TLNKhanh/TinyKey/docs/images/board-bottom.png

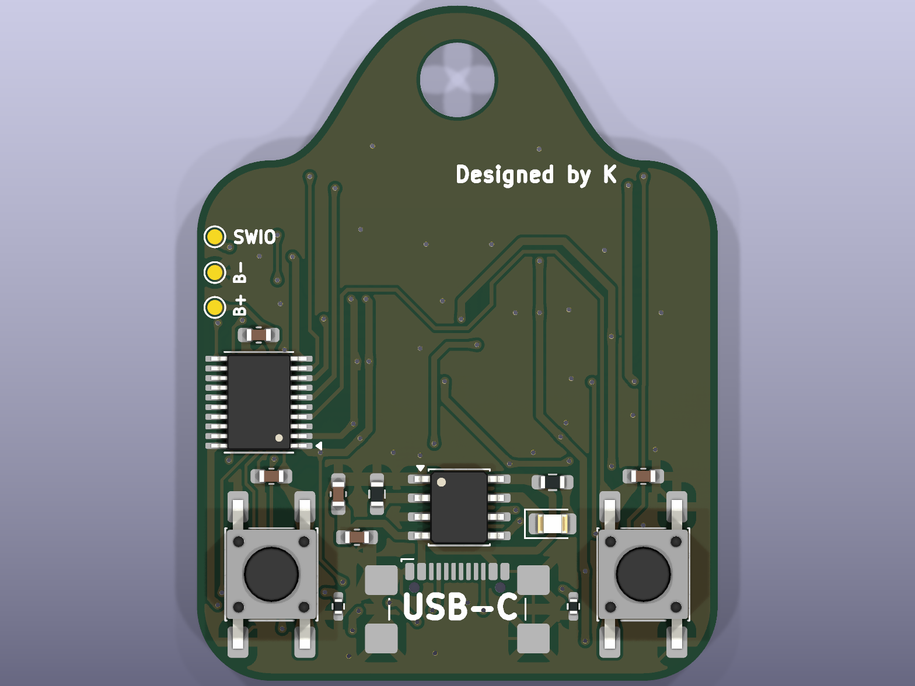
docs/images/board-bottom.png
