TLNKhanh/TinyKey/docs/images/board-hero.jpg

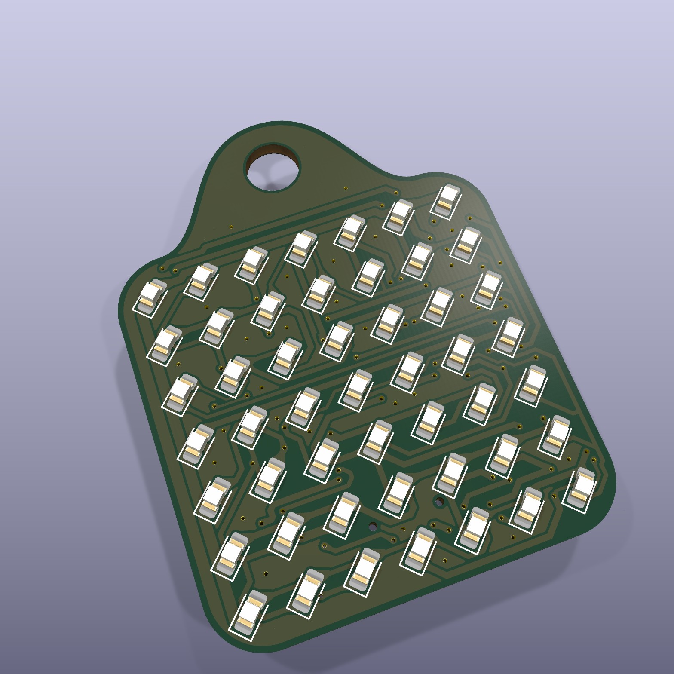
docs/images/board-hero.jpg
