TLNKhanh/TinyKey/docs/images/board-top.png

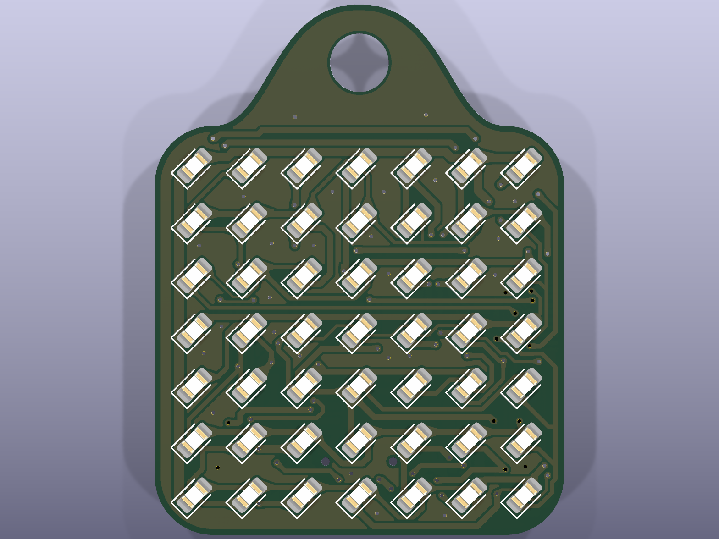
docs/images/board-top.png
