TLNKhanh/TinyKey/docs/images/schematic.png

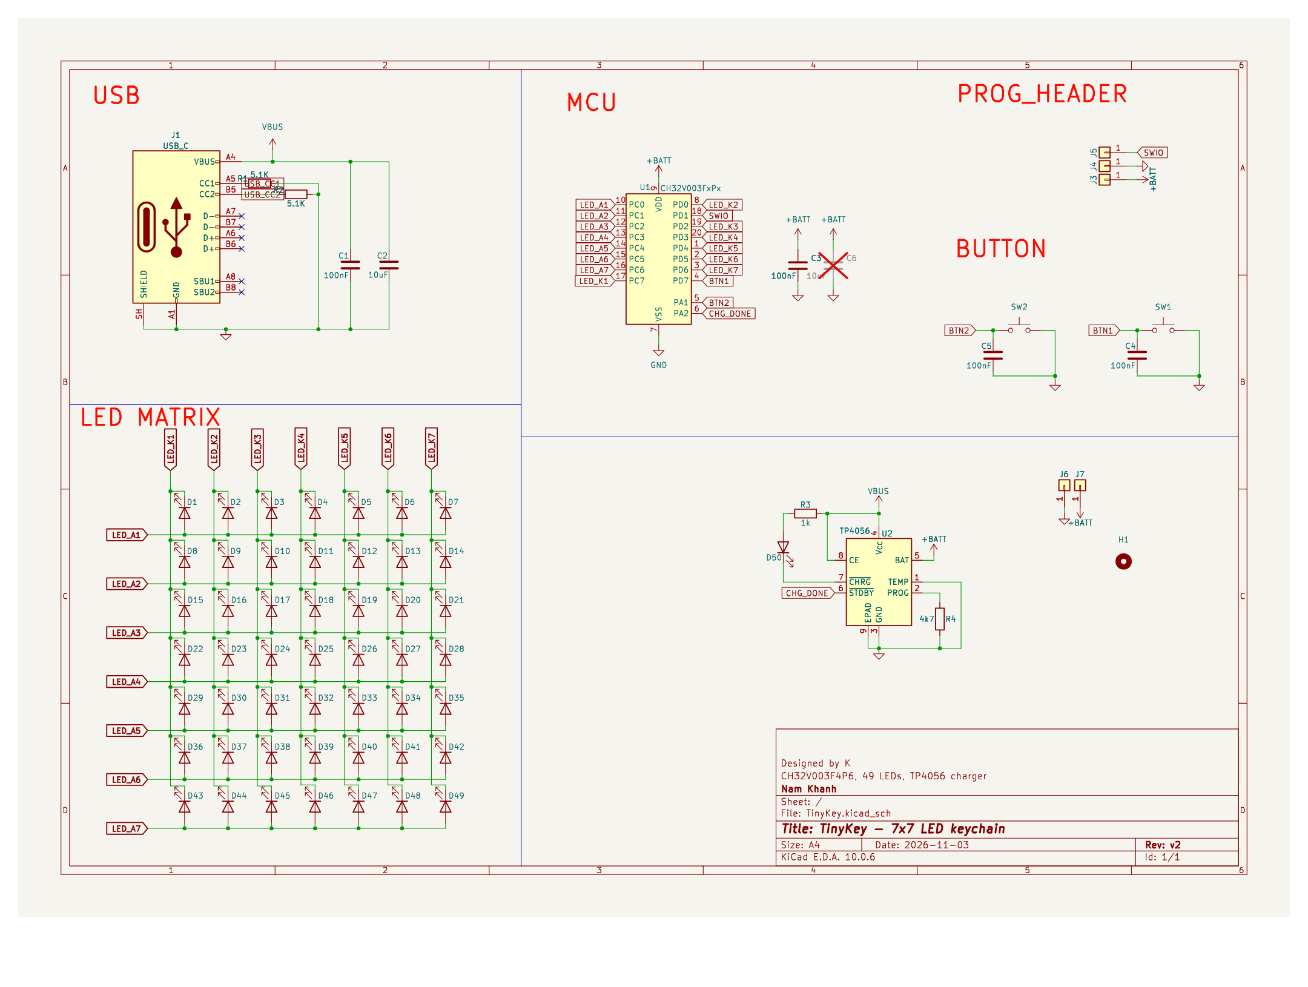
docs/images/schematic.png
