TLNKhanh/TinyKey/hardware/bom.csv

Refs | Value | Footprint | Qty | DNP
C1,C3-C5 | 100nF | Capacitor_SMD:C_0603_1608Metric_Pad1.08x0.95mm_HandSolder | 4
C2 | 10uF | Capacitor_SMD:C_0603_1608Metric_Pad1.08x0.95mm_HandSolder | 1
D1-D50 | LED | LED_SMD:LED_0805_2012Metric_Pad1.15x1.40mm_HandSolder | 50
J1 | USB_C | Connector_USB:USB_C_Receptacle_GCT_USB4110 | 1
J3,J5-J7 | Conn_01x01 | TestPoint:TestPoint_Pad_D1.0mm | 4
R1,R2 | 5.1K | Resistor_SMD:R_0402_1005Metric_Pad0.72x0.64mm_HandSolder | 2
R3 | 1k | Resistor_SMD:R_0603_1608Metric_Pad0.98x0.95mm_HandSolder | 1
R4 | 4k7 | Resistor_SMD:R_0603_1608Metric_Pad0.98x0.95mm_HandSolder | 1
SW1,SW2 | SW_Push | Button_Switch_SMD:SW_Push_1P1T_NO_E-Switch_TL3301NxxxxxG | 2
U1 | CH32V003FxPx | Package_SO:TSSOP-20_4.4x6.5mm_P0.65mm | 1
U2 | TP4056 | Package_SO:SOIC-8-1EP_3.9x4.9mm_P1.27mm_EP2.41x3.81mm | 1
