TLNKhanh/TinyKey/docs/hardware/TinyKey-pcb-top.pdf

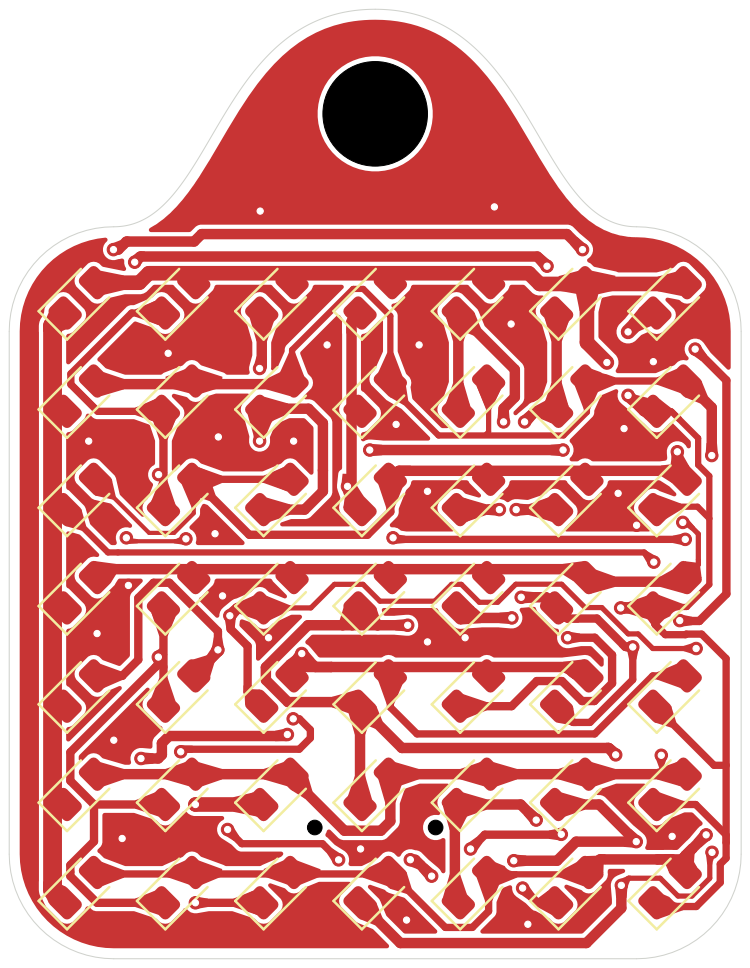
[picture p8: page 1]

Size: A4 | Rev:
KiCad E.D.A. 10.0.6 | Id: 1/1
