TLNKhanh/TinyKey/docs/hardware/TinyKey-schematic.pdf

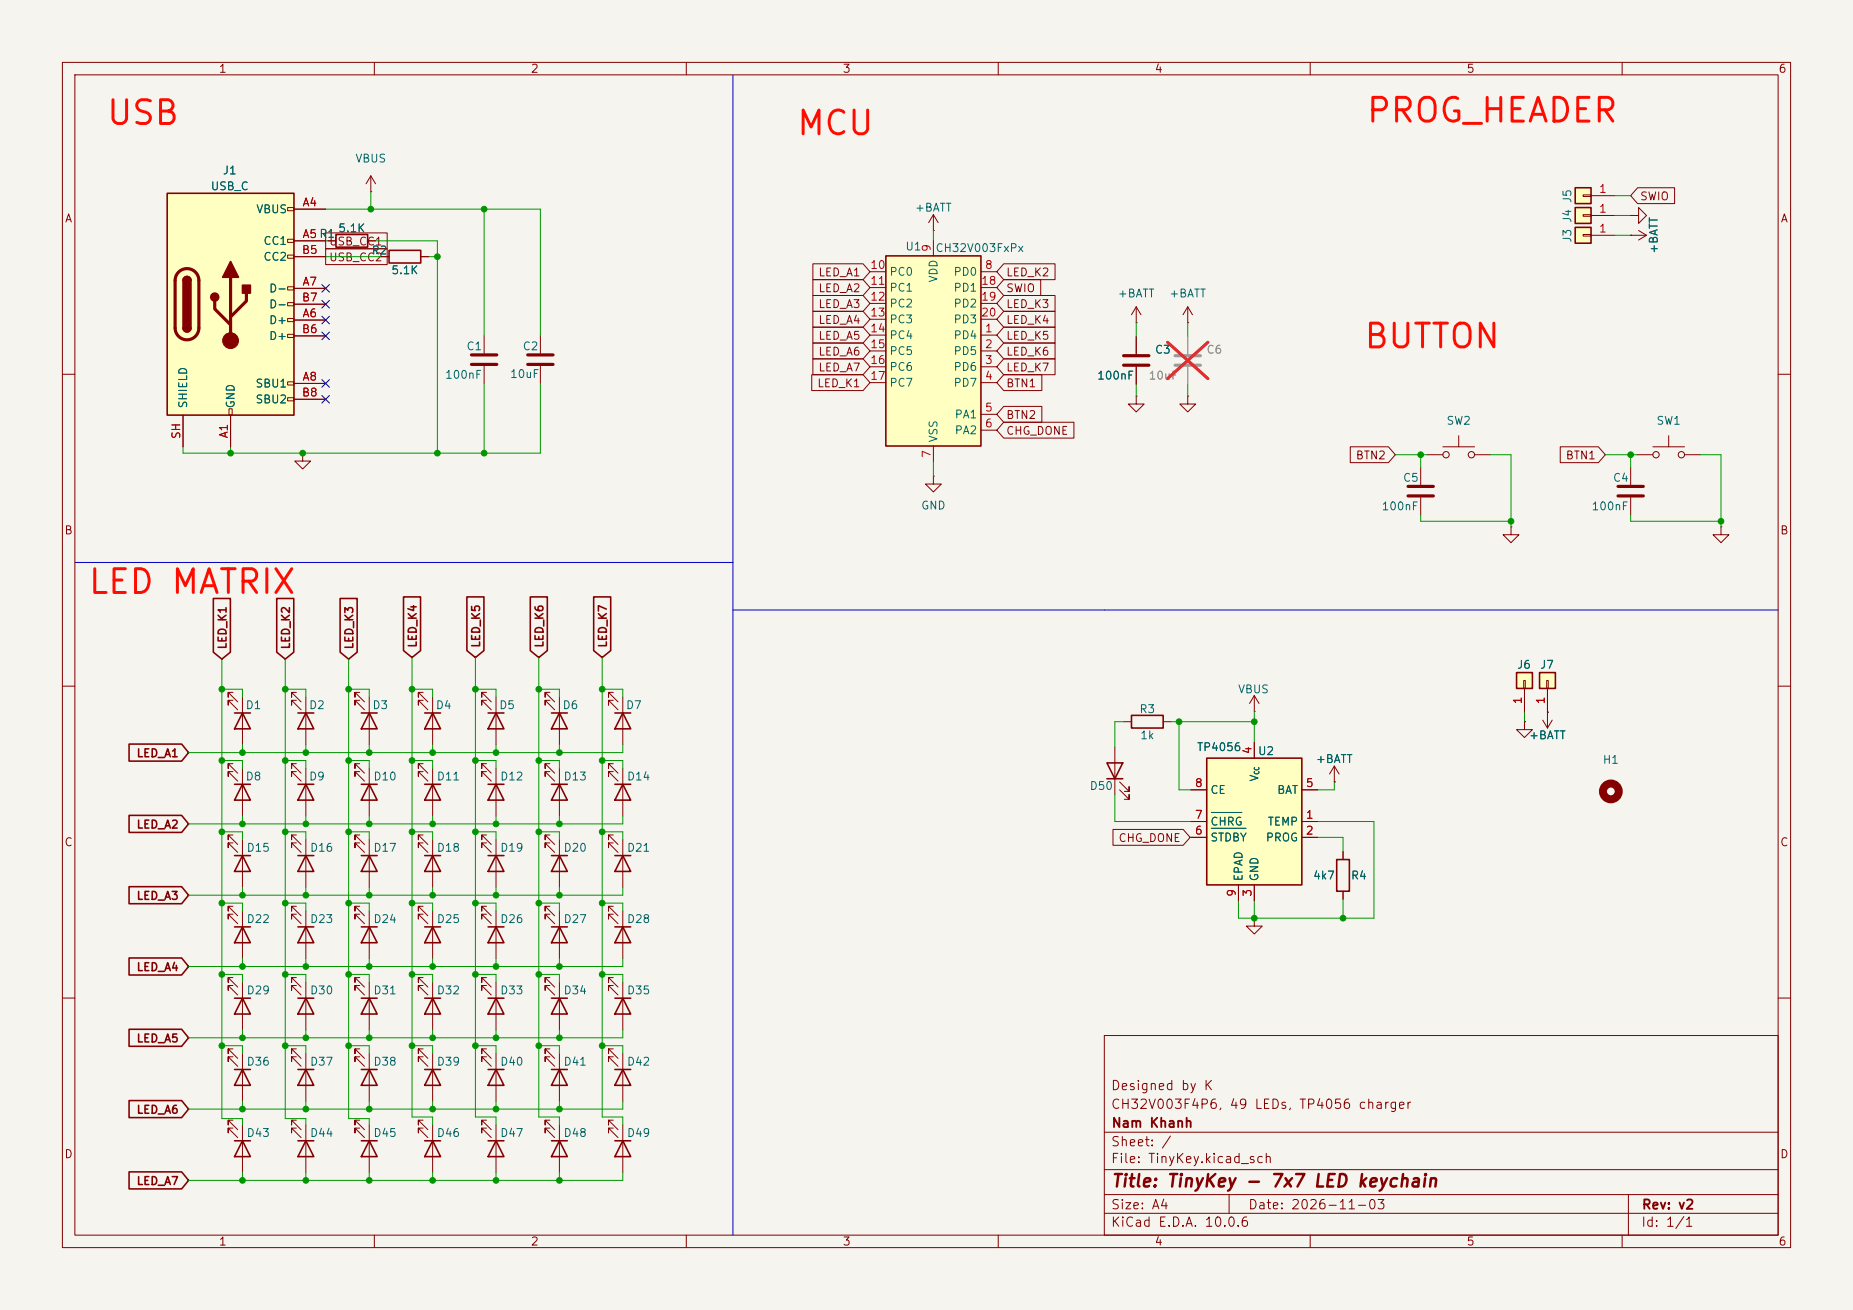
[picture p9: page 1]

Designed by K
CH32V003F4P6, 49 LEDs, TP4056 charger
Nam Khanh
Sheet: /
File: TinyKey.kicad_sch
Title: TinyKey - 7x7 LED keychain

Size: A4 | Rev: v2
KiCad E.D.A. 10.0.6 | Id: 1/1
