TLNKhanh/TinyKey/hardware/TinyKey.kicad_pcb

## KiCad design hardware/TinyKey.kicad_pcb (2026-11-03)

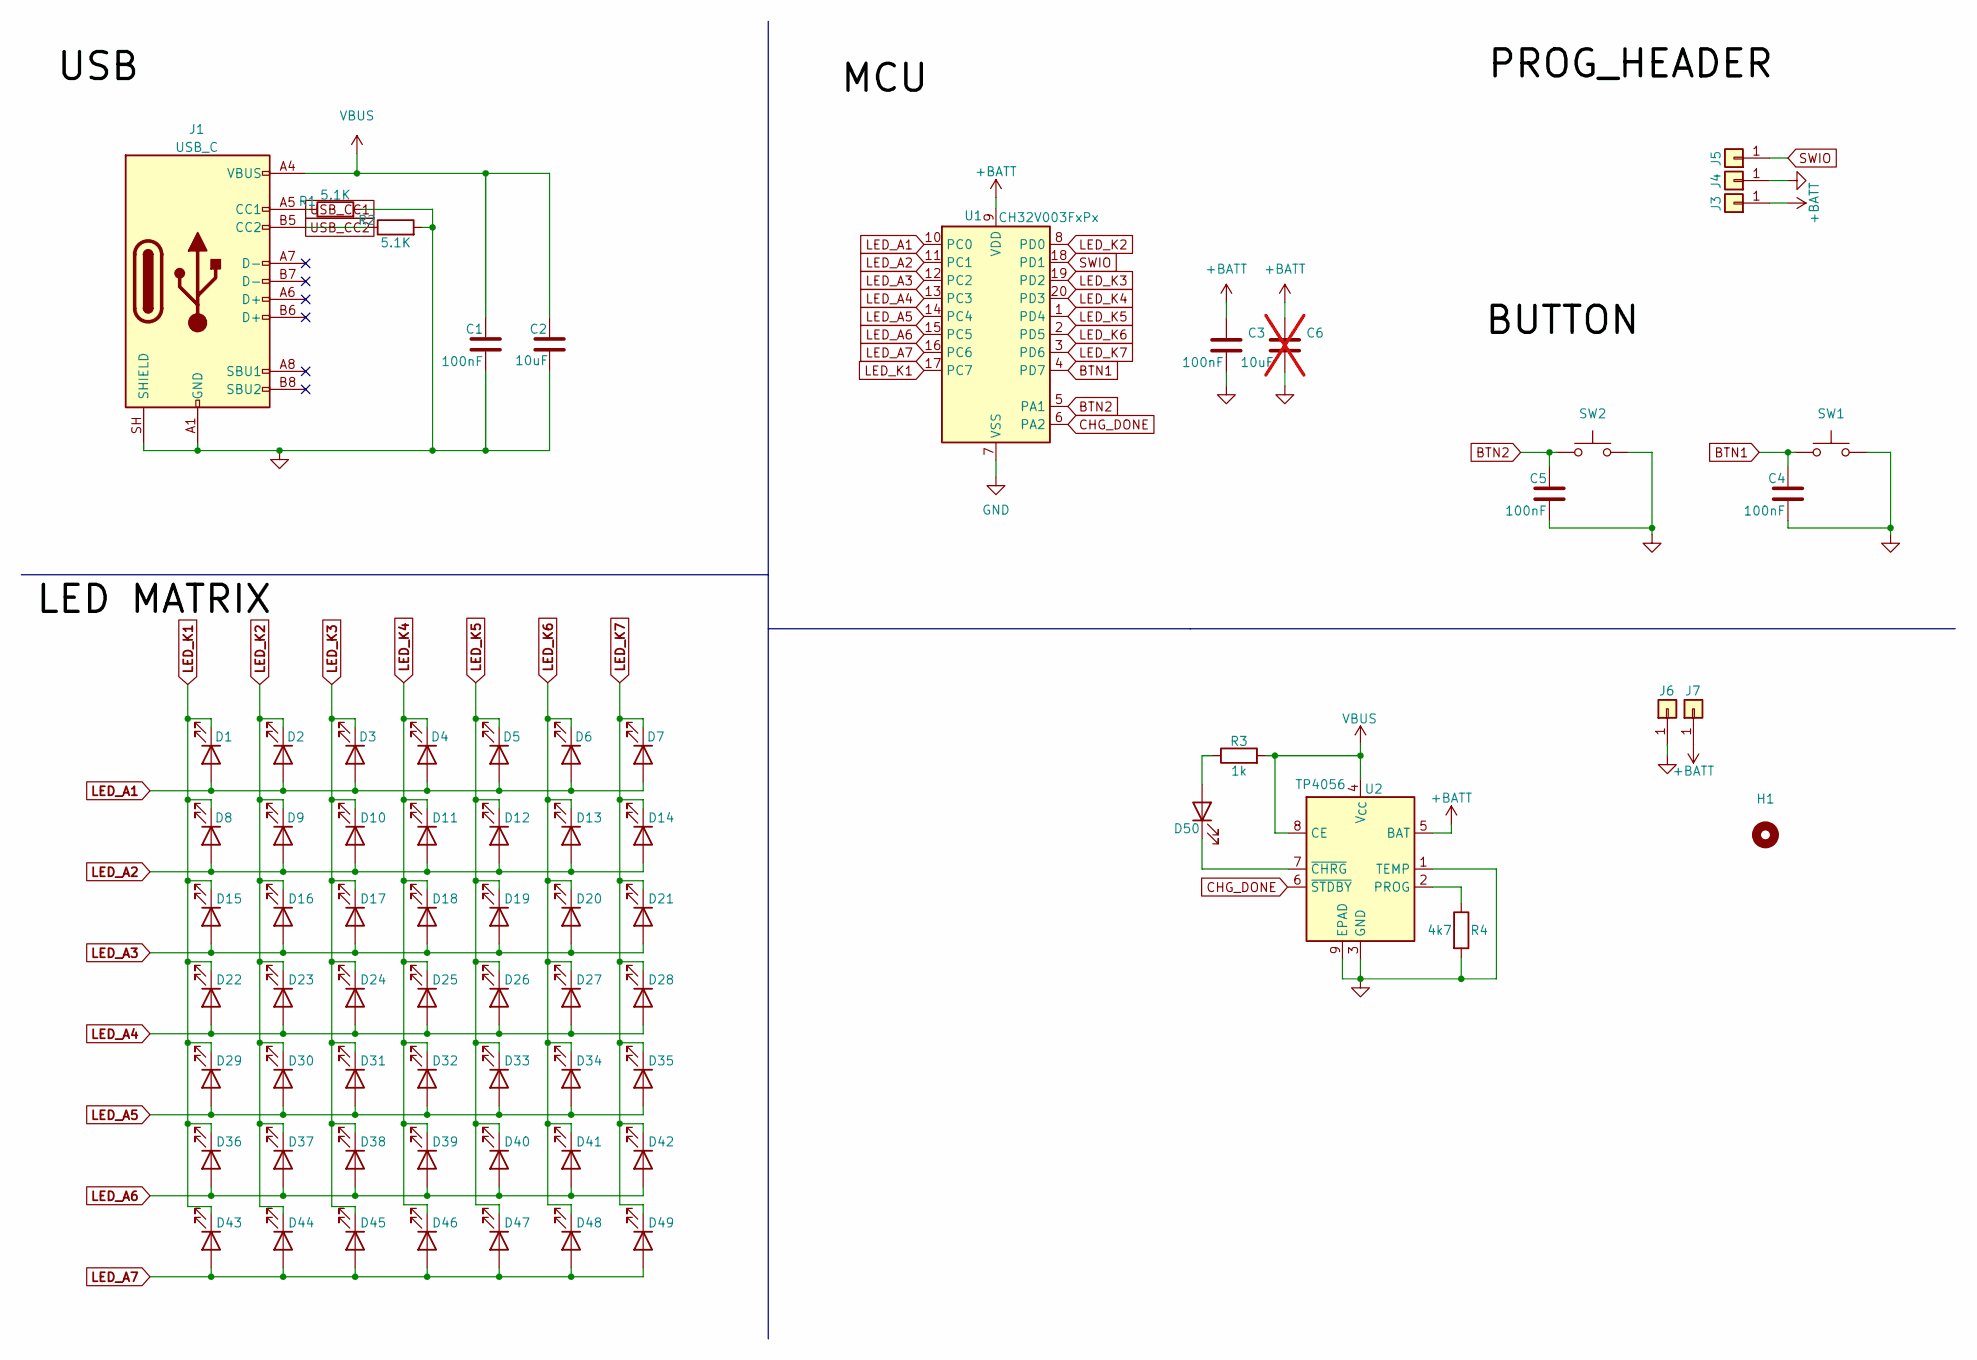
[picture p10: schematic TinyKey.kicad_sch]

Parts:
C1, C3, C4, C5: 100nF; C_0603_1608Metric_Pad1.08x0.95mm_HandSolder
C2: 10uF; C_0603_1608Metric_Pad1.08x0.95mm_HandSolder
C6: 10uF; C_0603_1608Metric_Pad1.08x0.95mm_HandSolder; not fitted
D1, D2, D3, D4, D5, D6, D7, D8, D9, D10, D11, D12, D13, D14, D15, D16, D17, D18, D19, D20, D21, D22, D23, D24, D25, D26, D27, D28, D29, D30, D31, D32, D33, D34, D35, D36, D37, D38, D39, D40, D41, D42, D43, D44, D45, D46, D47, D48, D49, D50: LED; LED_0805_2012Metric_Pad1.15x1.40mm_HandSolder
H1: MountingHole_5mm
J1: USB_C; USB_C_Receptacle_GCT_USB4110
J3, J4, J5, J6, J7: Conn_01x01; TestPoint_Pad_D1.0mm
R1, R2: 5.1K; R_0402_1005Metric_Pad0.72x0.64mm_HandSolder
R3: 1k; R_0603_1608Metric_Pad0.98x0.95mm_HandSolder
R4: 4k7; R_0603_1608Metric_Pad0.98x0.95mm_HandSolder
SW1, SW2: SW_Push; SW_Push_1P1T_NO_E-Switch_TL3301NxxxxxG
U1: CH32V003FxPx; TSSOP-20_4.4x6.5mm_P0.65mm
U2: TP4056; SOIC-8-1EP_3.9x4.9mm_P1.27mm_EP2.41x3.81mm

Connections:
+BATT: C3.1, C6.1, J3.1, J7.1 (Pin_1_1), U1.9 (VDD), U2.5 (BAT)
BTN1: C4.1, SW1.1, U1.4 (PD7)
BTN2: C5.1, SW2.1, U1.5 (PA1)
CHG_DONE: U1.6 (PA2), U2.6 (~STDBY)
GND: C1.2, C2.2, C3.2, C4.2, C5.2, C6.2, J1.A1 (GND), J1.A12 (GND), J1.B1 (GND), J1.B12 (GND), J1.SH (SHIELD), J4.1, J6.1 (Pin_1_1), R1.2, R2.2, R4.2, SW1.2, SW2.2, U1.7 (VSS), U2.1 (TEMP), U2.3 (GND), U2.9 (EPAD)
LED_A1: D1.2 (A), D2.2 (A), D3.2 (A), D4.2 (A), D5.2 (A), D6.2 (A), D7.2 (A), U1.10 (PC0)
LED_A2: D8.2 (A), D9.2 (A), D10.2 (A), D11.2 (A), D12.2 (A), D13.2 (A), D14.2 (A), U1.11 (PC1)
LED_A3: D15.2 (A), D16.2 (A), D17.2 (A), D18.2 (A), D19.2 (A), D20.2 (A), D21.2 (A), U1.12 (PC2)
LED_A4: D22.2 (A), D23.2 (A), D24.2 (A), D25.2 (A), D26.2 (A), D27.2 (A), D28.2 (A), U1.13 (PC3)
LED_A5: D29.2 (A), D30.2 (A), D31.2 (A), D32.2 (A), D33.2 (A), D34.2 (A), D35.2 (A), U1.14 (PC4)
LED_A6: D36.2 (A), D37.2 (A), D38.2 (A), D39.2 (A), D40.2 (A), D41.2 (A), D42.2 (A), U1.15 (PC5)
LED_A7: D43.2 (A), D44.2 (A), D45.2 (A), D46.2 (A), D47.2 (A), D48.2 (A), D49.2 (A), U1.16 (PC6)
LED_K1: D1.1 (K), D8.1 (K), D15.1 (K), D22.1 (K), D29.1 (K), D36.1 (K), D43.1 (K), U1.17 (PC7)
LED_K2: D2.1 (K), D9.1 (K), D16.1 (K), D23.1 (K), D30.1 (K), D37.1 (K), D44.1 (K), U1.8 (PD0)
LED_K3: D3.1 (K), D10.1 (K), D17.1 (K), D24.1 (K), D31.1 (K), D38.1 (K), D45.1 (K), U1.19 (PD2)
LED_K4: D4.1 (K), D11.1 (K), D18.1 (K), D25.1 (K), D32.1 (K), D39.1 (K), D46.1 (K), U1.20 (PD3)
LED_K5: D5.1 (K), D12.1 (K), D19.1 (K), D26.1 (K), D33.1 (K), D40.1 (K), D47.1 (K), U1.1 (PD4)
LED_K6: D6.1 (K), D13.1 (K), D20.1 (K), D27.1 (K), D34.1 (K), D41.1 (K), D48.1 (K), U1.2 (PD5)
LED_K7: D7.1 (K), D14.1 (K), D21.1 (K), D28.1 (K), D35.1 (K), D42.1 (K), D49.1 (K), U1.3 (PD6)
unnamed: D50.2 (A), R3.1
unnamed: D50.1 (K), U2.7 (~CHRG)
unnamed: R4.1, U2.2 (PROG)
SWIO: J5.1 (Pin_1_1), U1.18 (PD1)
USB_CC1: J1.A5 (CC1), R1.1
USB_CC2: J1.B5 (CC2), R2.1
VBUS: C1.1, C2.1, J1.A4 (VBUS), J1.A9 (VBUS), J1.B4 (VBUS), J1.B9 (VBUS), R3.2, U2.4 (V_{CC}), U2.8 (CE)

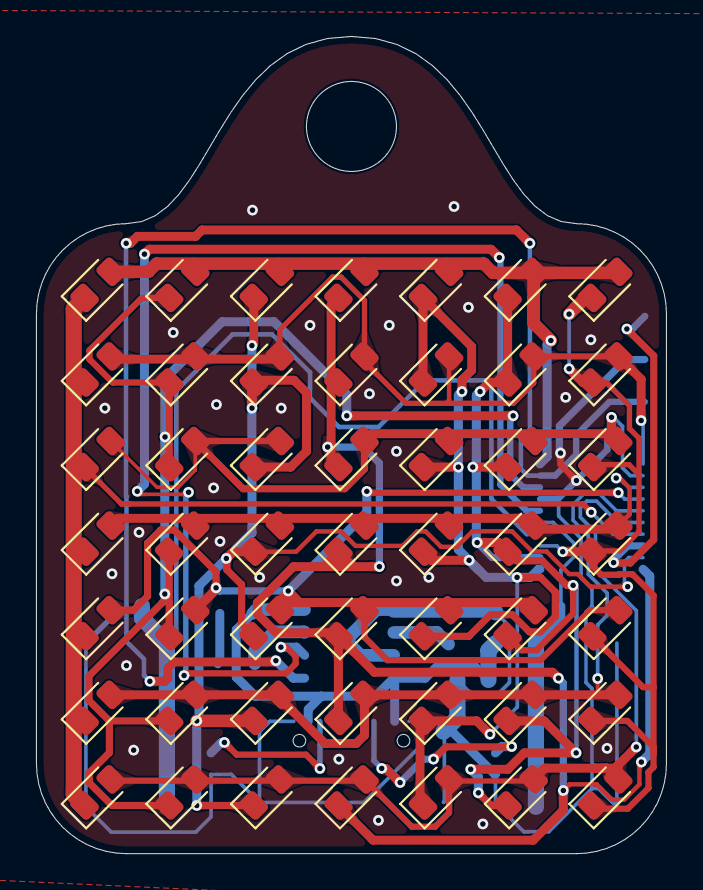
[picture p11: board TinyKey.kicad_pcb from above]

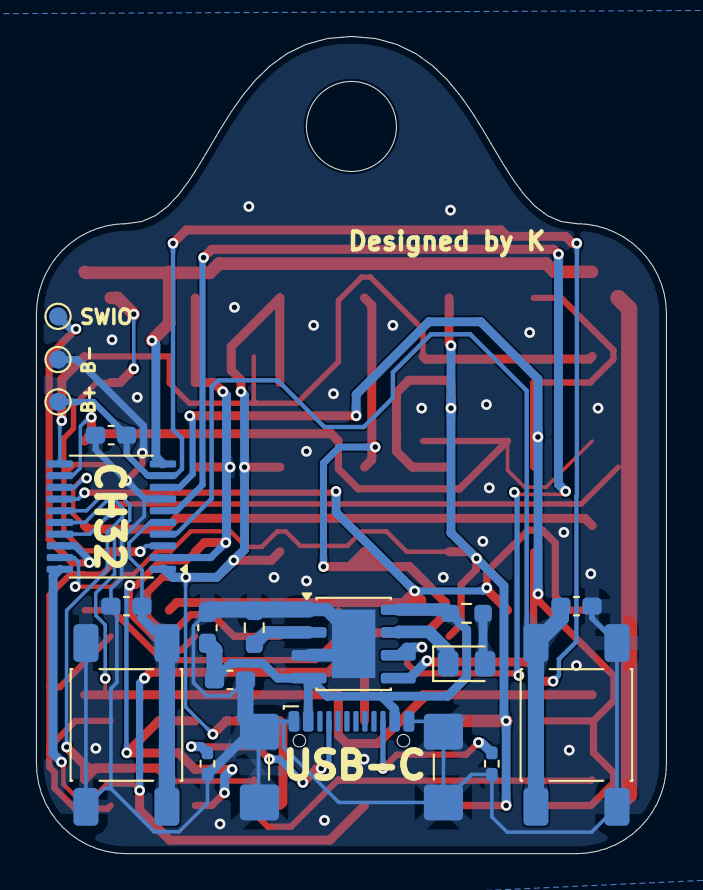
[picture p12: board TinyKey.kicad_pcb from below]

Board: 2 copper layers, 35.0 x 45.4 mm, 68 parts (18 on the bottom side), 26 nets.
