TLNKhanh/TinyKey/(commit log)

2026-11-03 Initial commit: TinyKey firmware and hardware
    - Arduino firmware (tinykey_v2): 15-step PWM, 8 effects, 5x7 font
    - C firmware on ch32v003fun: 14 effects, constant-dwell row scan
    - KiCad board, schematic, gerbers and fab zip
    - docs for the board quirks (reversed LEDs, no series resistors, PD7/NRST)
    - flashing helpers and prebuilt binaries
    [TinyKey-B_Cu.gbr, TinyKey-B_Mask.gbr, TinyKey-B_Paste.gbr, TinyKey-B_Silkscreen.gbr, TinyKey-Edge_Cuts.gbr, TinyKey-F_Cu.gbr, TinyKey-F_Mask.gbr, TinyKey-F_Paste.gbr]
2026-11-03 Add board renders, schematic exports and photo guide
    - 3D renders of the current PCB (front, back, hero) generated with kicad-cli
    - schematic PDF and PNG preview in docs/
    - hardware/README.md with fabrication notes and render commands
    - docs/photos.md shot list for the assembled keychain
2026-11-03 Add fab PDFs, BOM and title block; rewrite README
    - schematic title block filled (TinyKey, rev v2, Nam Khanh, date)
    - PCB top/bottom PDF exports and a grouped BOM in hardware/
    - README rewritten in first person with hardware and software sections
    - hardware/README.md documents the exports and fab notes
    [TinyKey.kicad_sch, bom.csv]
2026-11-03 Set scroll text to Nam Khanh and rebuild prebuilt
    - TEXTS[] now scrolls Nam Khanh; prebuilt tinykey_v2.bin rebuilt (9100 B, md5 C33EB38A51121352C6659D109233EAC7)
    - size/checksum references in README, firmware/arduino/README.md, prebuilt/README.md and CHANGELOG updated
2026-11-03 Add real photos of the assembled keychain
    - docs/images/photo-front.jpg (1400 px) and photo-back.jpg (1200 px), EXIF stripped
    - README hero and hardware table now use the photos; renders stay for the bare board
    - docs/photos.md updated with what is done and what is still missing
2026-11-03 Refocus README on the ten cent MCU and split V1/V2 clearly
    - new 'Why a ten cent MCU' section: what the CH32V003 costs and what that buys
    - V1 (photos, built, 40 x 52 mm) vs V2 (files, not built, 35 x 45.4 mm)
    - README trimmed back after the rewrite; hardware/ and docs/hardware.md say the
    same thing about the revisions
2026-11-03 Rewrite Arduino sketch with comments, Hello World demo and WFI sleep
    - sketch is now the improved version: px/disp split, quarter-step blend, UTF-8
    text with a/agrave/aacute glyphs, 9 generated patterns, WFI sleep on BTN2
    - demo text is Hello World so the repo shows something neutral
    - section comments throughout: pin map, scan, blend, font, effects, buttons,
    sleep, setup order
    - prebuilt tinykey_v2.bin rebuilt (9172 B flash, 9340 B bin, md5 C83D8921...)
    - README: shorter ten cent MCU section, effects list and sleep updated
    - docs/hardware.md: new Sleep section, including what the C firmware does
    [tinykey_v2.ino]
